kos-pal/philon_imm_robot/PCBs/README.md

These folders contain .json files that can be dragged and dropped in EasyEda to import the schematics as well as the pcb designs for all the boards used in the robot.
