kos-pal/philon_imm_robot/PCBs/servo board/README.md

servo_board

This board connects to the Arduino nano that operates the 3 servo motors. The board implements RS-485 for the UART communication between the modules with a SN75176B ic,
3 optocoupler inputs for reading the inductive sensors used for zeroing the robot as well as terminals for the servo connections.
