kos-pal/philon_imm_robot/PCBs/y-z link board/README.md

y_z_link_board

This board is mounted on top of the X axis and is used to facilitate cabling by splitting the power and signal lines in a convenient location for service and maintenance.
