kos-pal/philon_imm_robot/PCBs/zmod board/README.md

zmod_board

This board connects to the Arduino nano that handles the gripper at the end of the Z axis. The board implements RS-485 for the UART communication between the
modules with a SN75176B ic, 3 relay channels for outputing signals to the Gripper, 3 optocoupler inputs for feedback and a mosfet for controlling the brake of the Z axis servo.
