kos-pal/philon_imm_robot/(threads)

Thread 1 (2023-01-12):

First attempt to run python seems to always fail.

ertygon, 2023-01-12:
Every morning after raspberry boots the first attempt to run communica.py always fail. The second (stop execution of python and run again without rebooting raspbian) always succeeds.
