kos-pal/philon_imm_robot/PCBs/zmod board/SCHEMATIC_z_mod_board.pdf

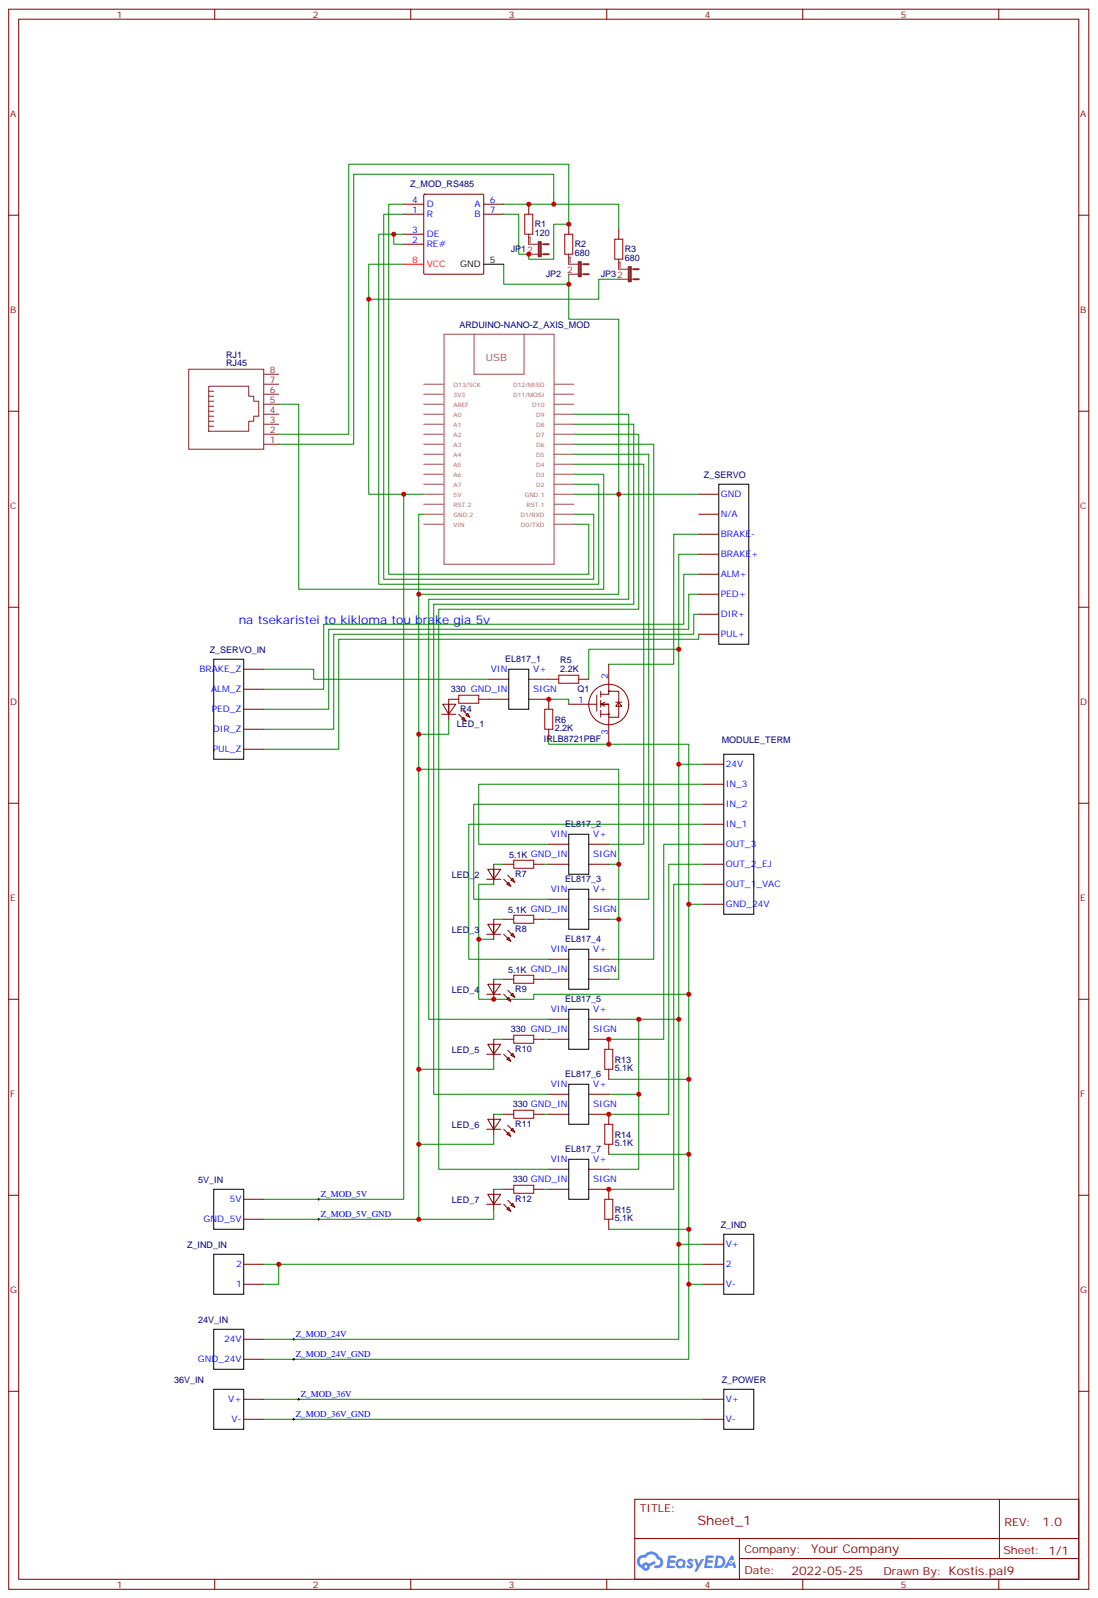
[picture p15: page 1]

na tsekaristei to kikloma tou brake gia 5v
