kos-pal/philon_imm_robot/PCBs/imm board/SCHEMATIC_imm_board.pdf

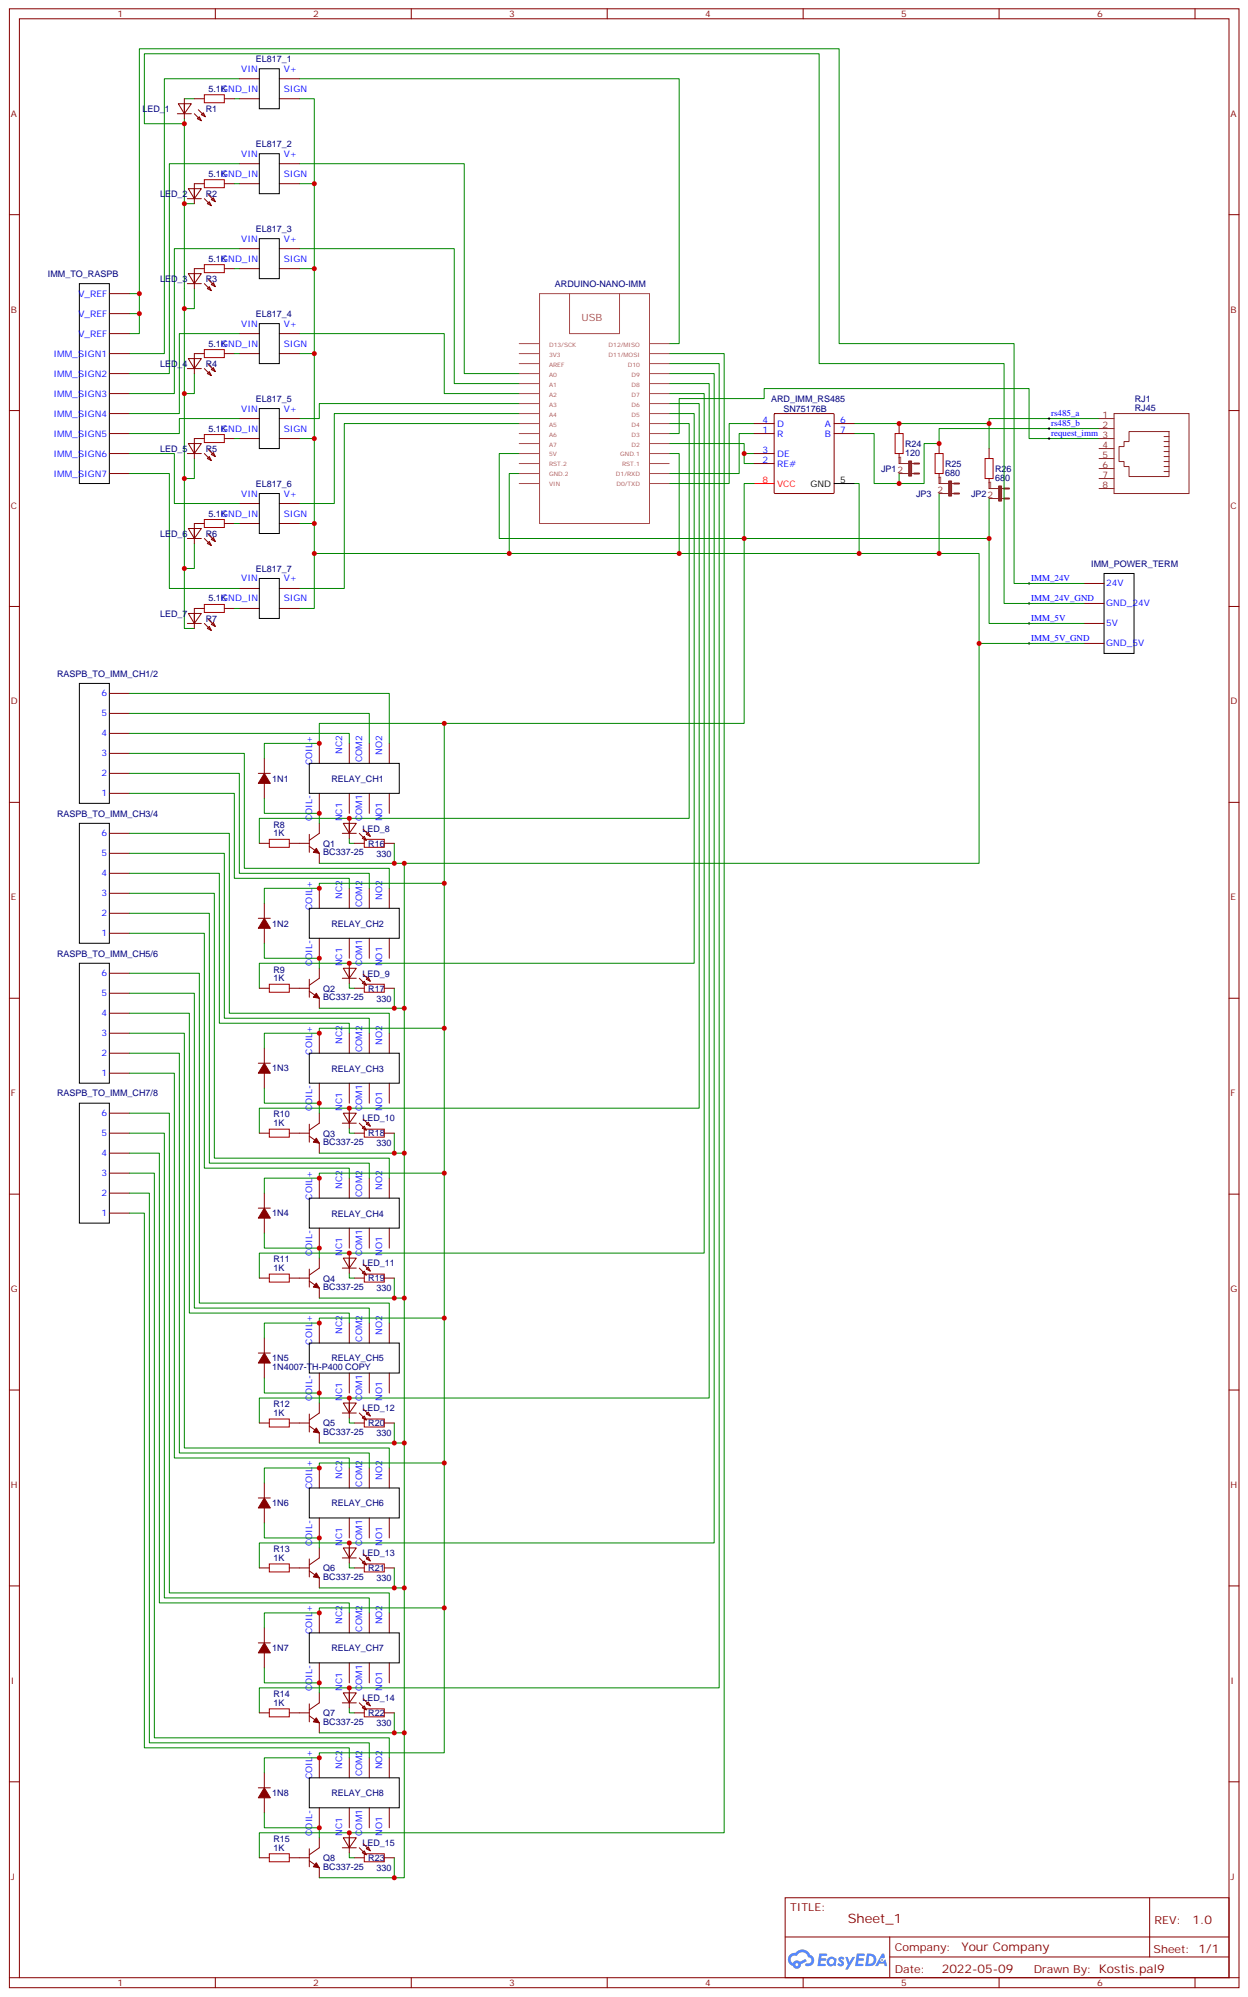
[picture p16: page 1]
