kos-pal/philon_imm_robot/PCBs/raspberry board/SCHEMATIC_raspb_board.pdf

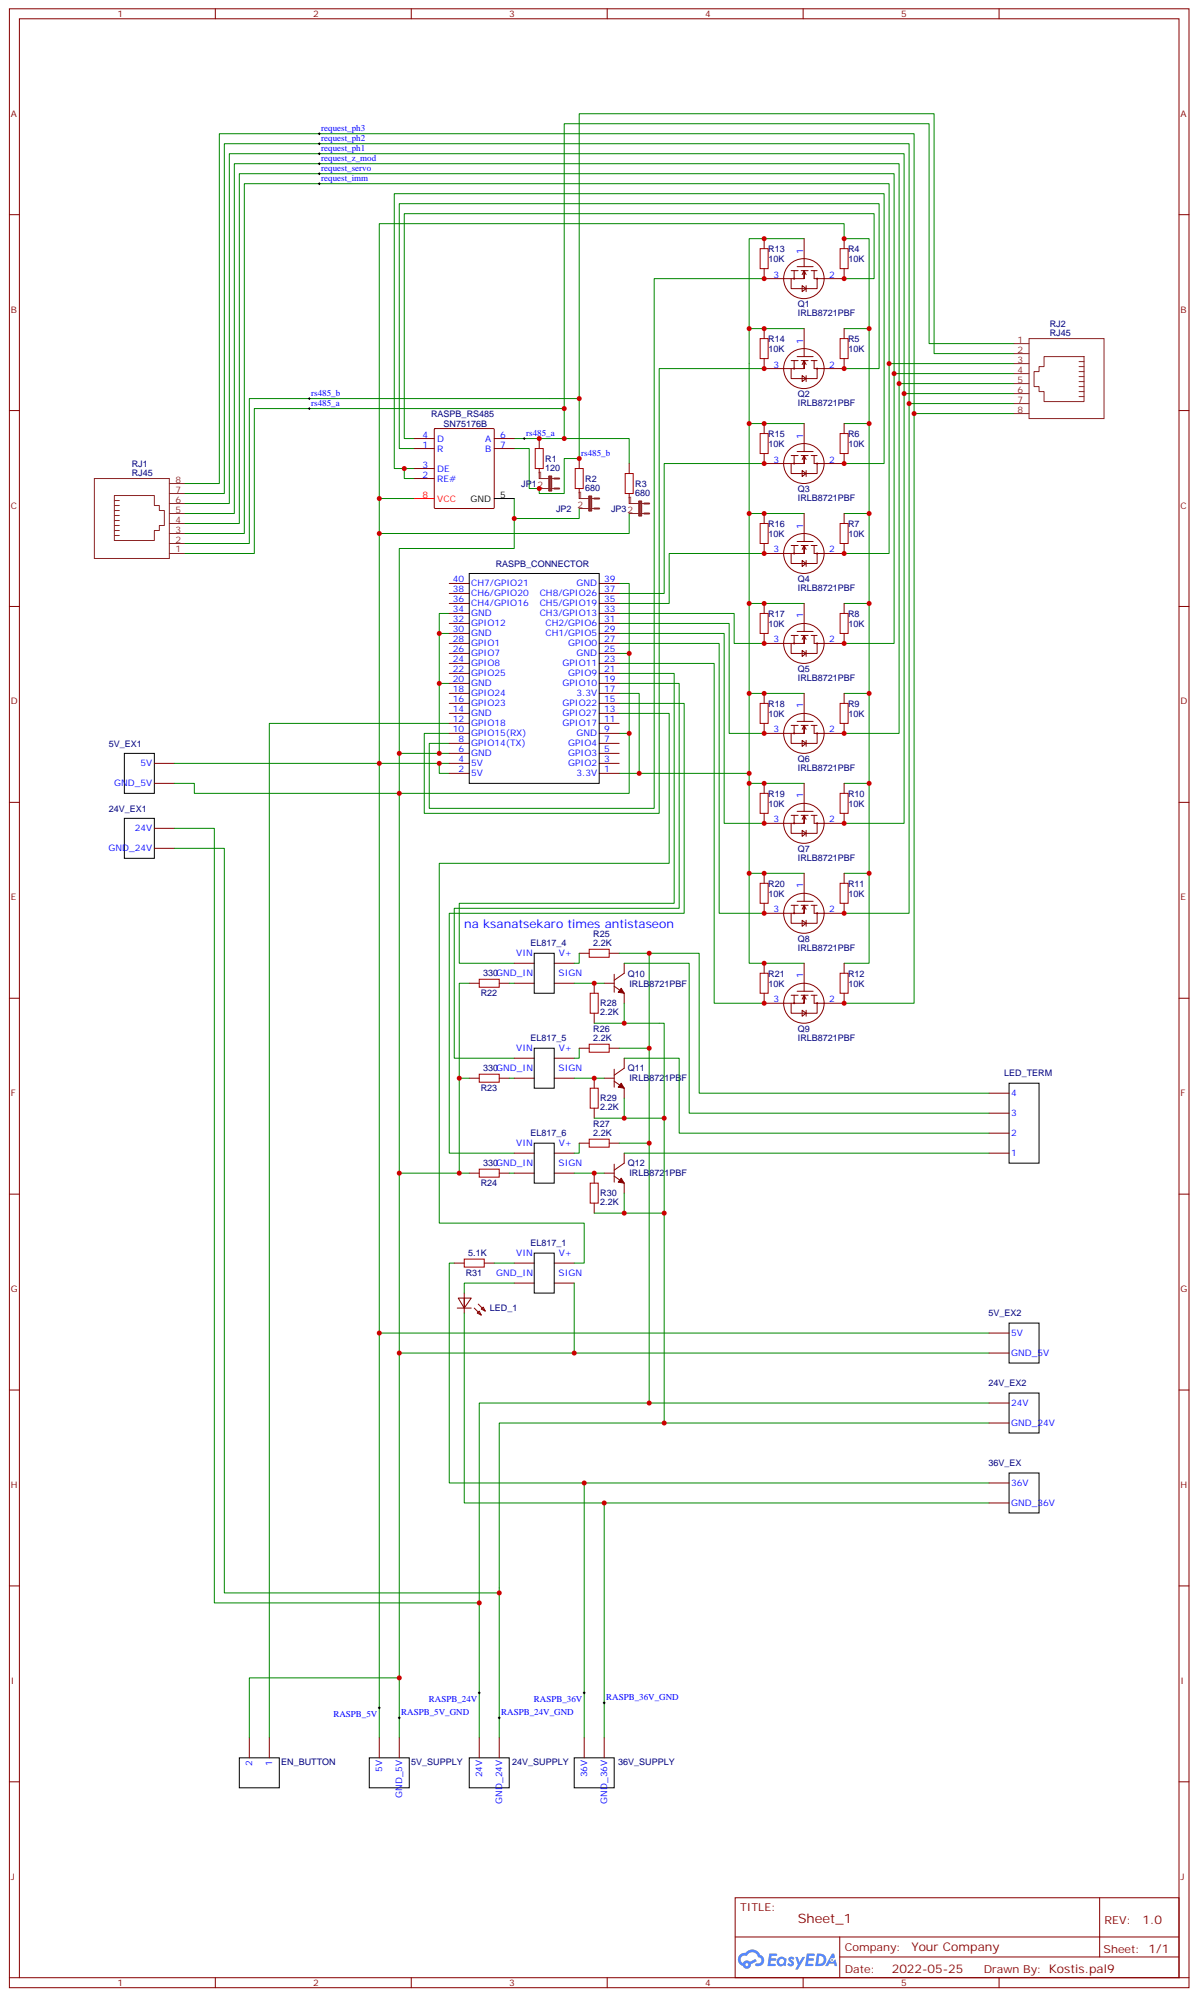
[picture p17: page 1]

request_ph2
request_ph1
request_z_mod
request_servo
request_imm

na ksanatsekaro times antistaseon
