kos-pal/philon_imm_robot/PCBs/servo board/SCHEMATIC_servo_board.pdf

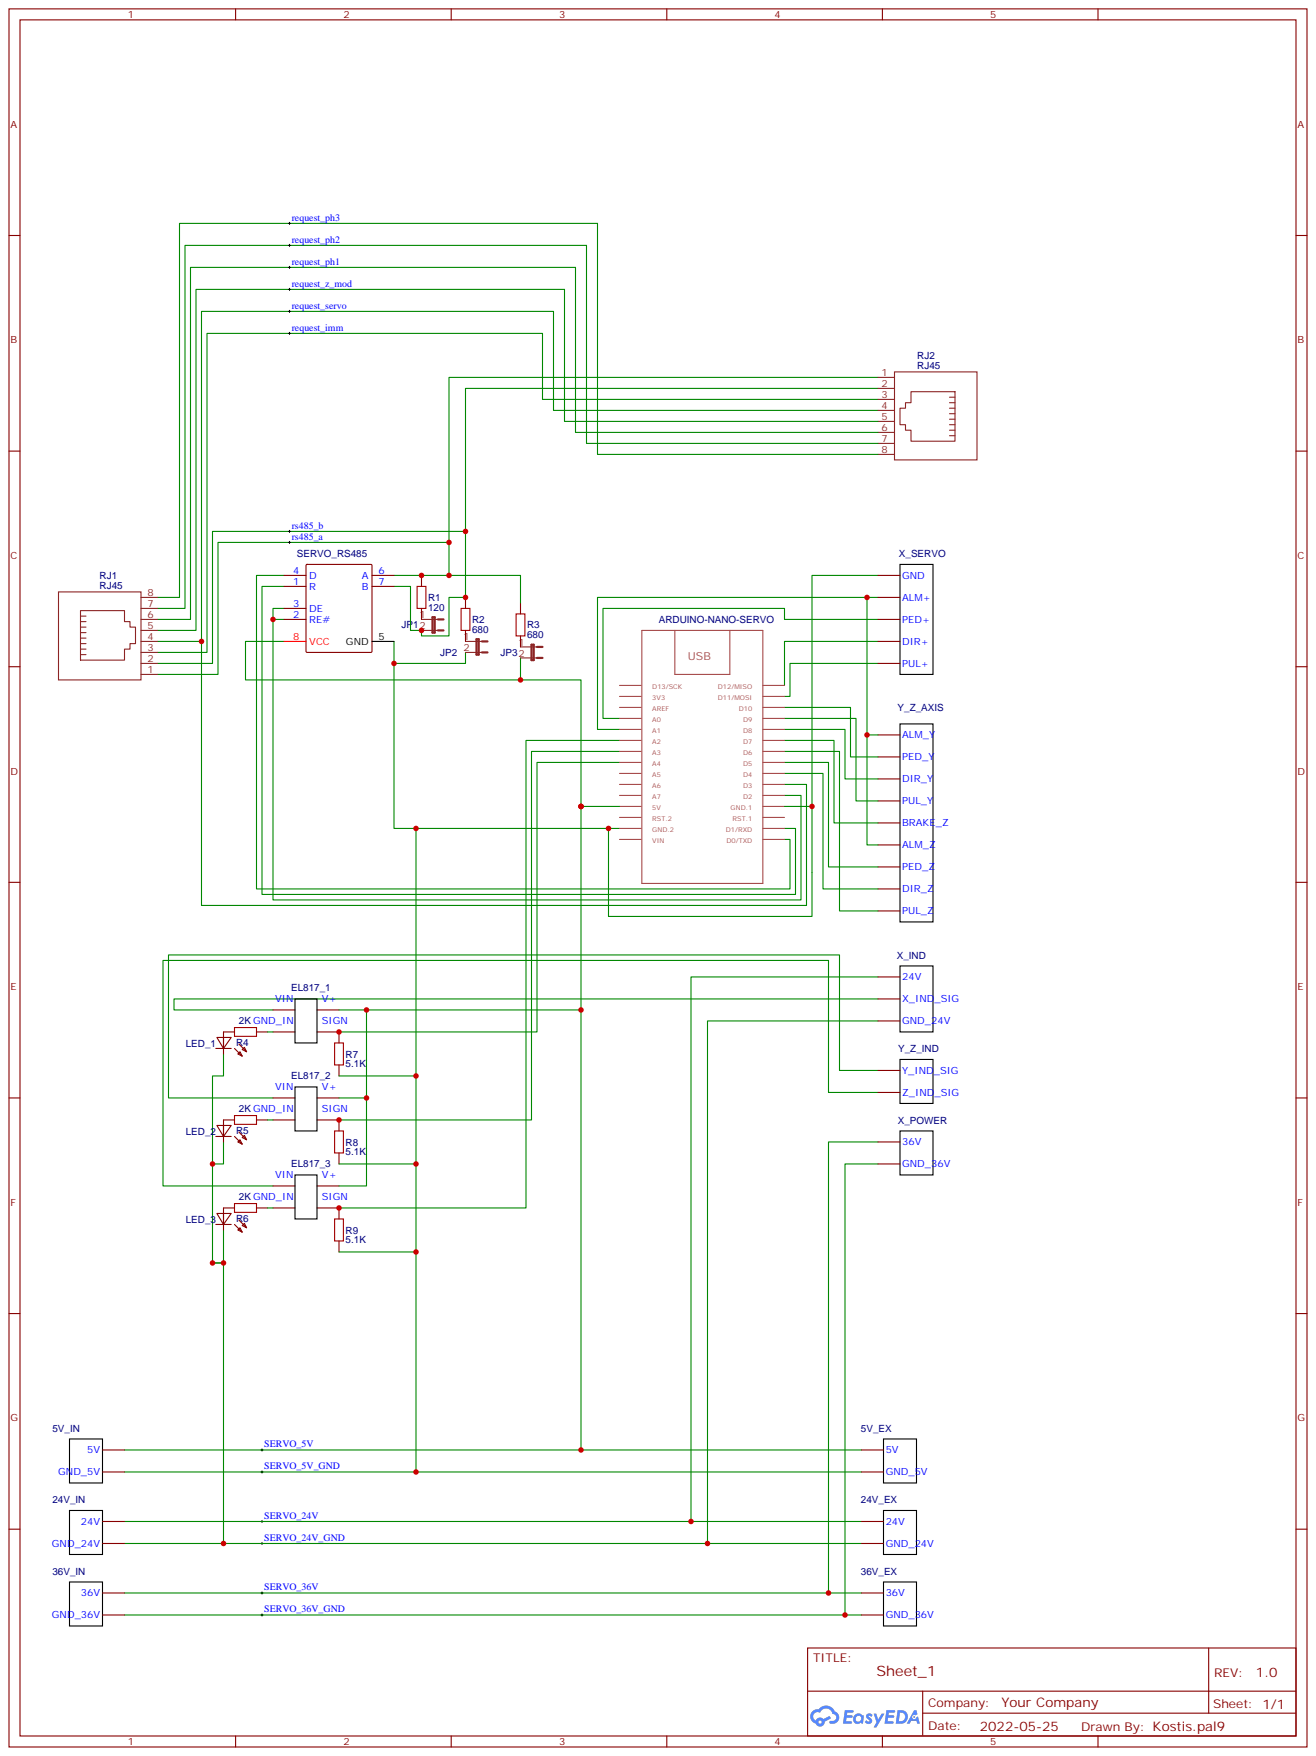
[picture p18: page 1]
