kos-pal/philon_imm_robot/PCBs/y-z link board/SCHEMATIC_y_z_board.pdf

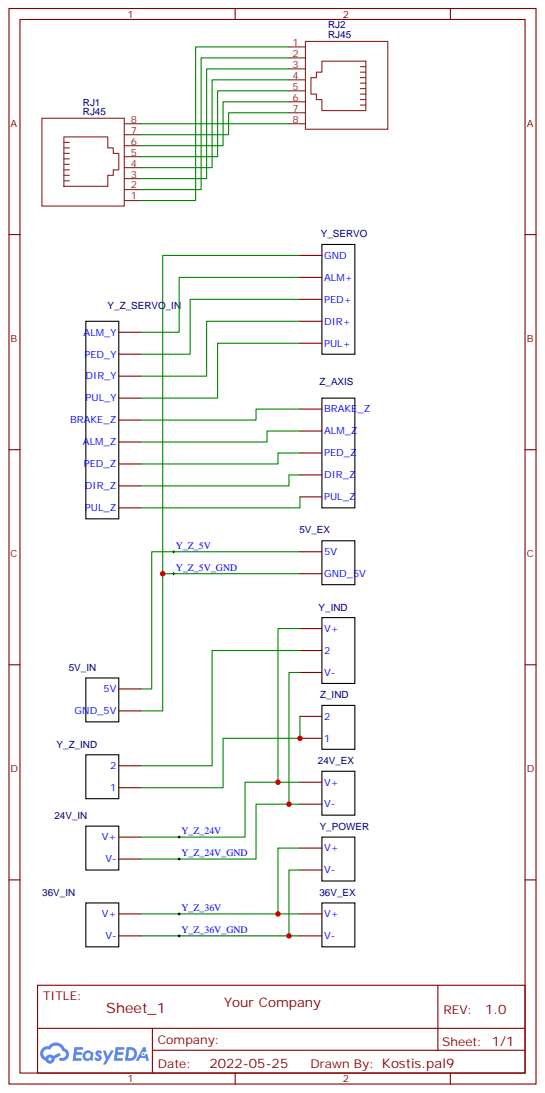
[picture p19: page 1]
