kos-pal/philon_imm_robot/PCBs/imm board/PCB_imm_board.pdf

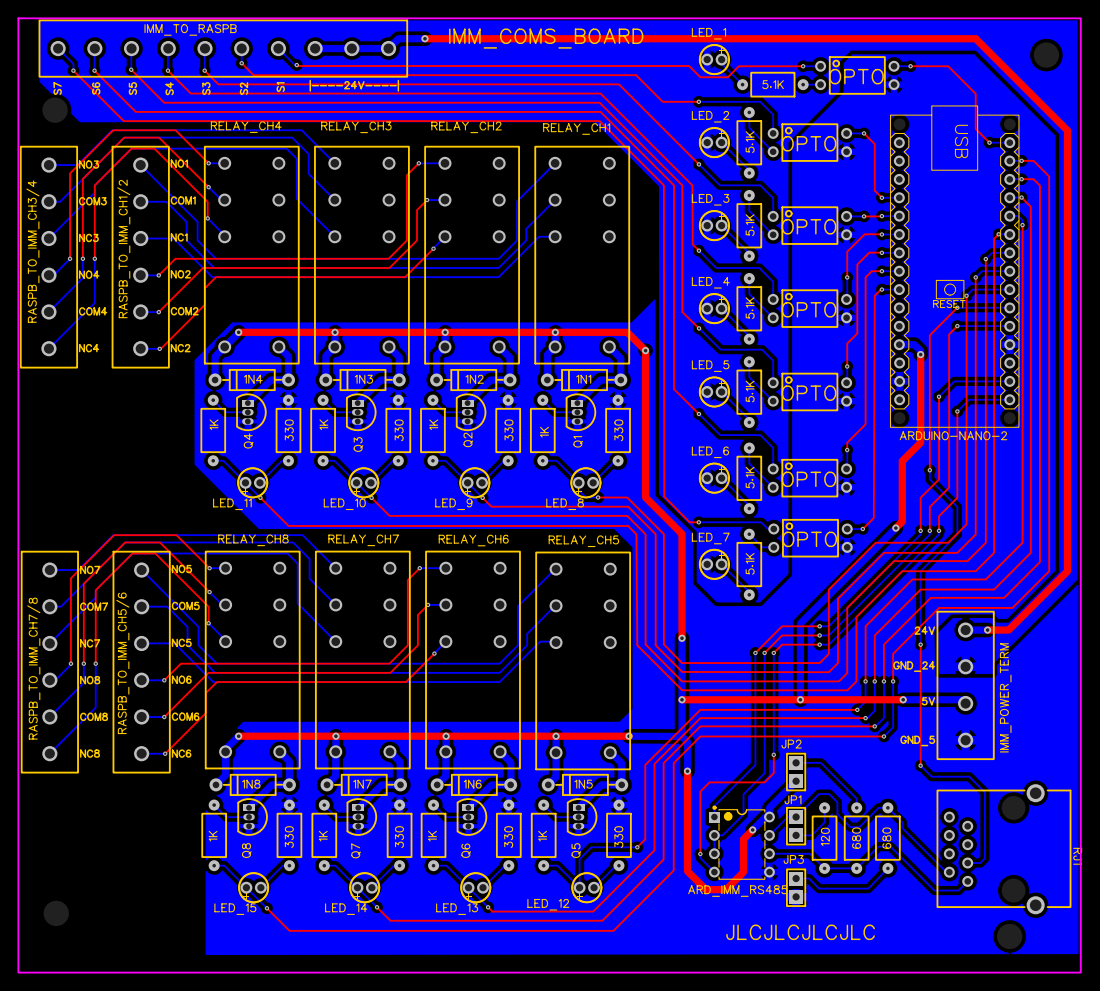
[picture p20: page 1]
