kos-pal/philon_imm_robot/PCBs/raspberry board/PCB_raspb_board.pdf

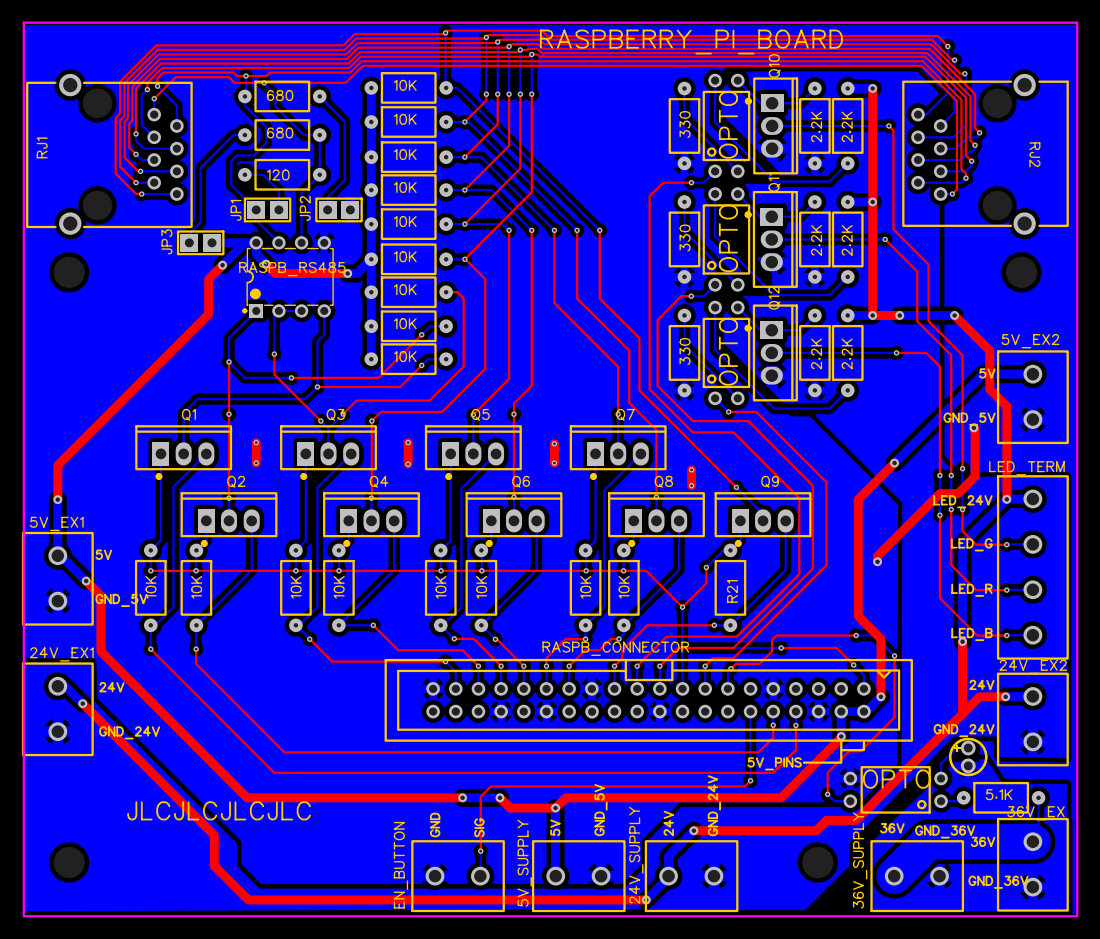
[picture p21: page 1]
