kos-pal/philon_imm_robot/PCBs/servo board/PCB_servo_board.pdf

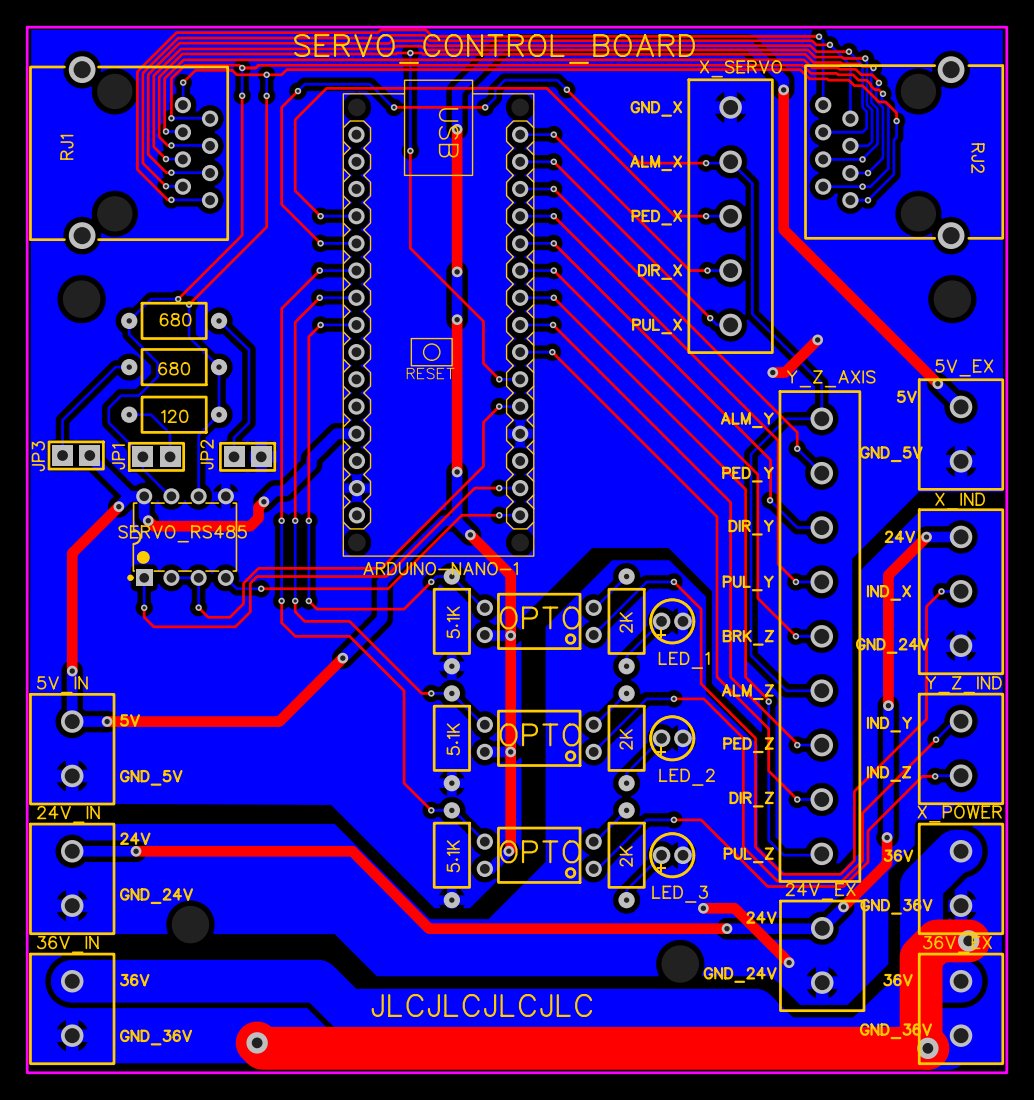
[picture p22: page 1]
