kos-pal/philon_imm_robot/PCBs/y-z link board/PCB_y_z_board.pdf

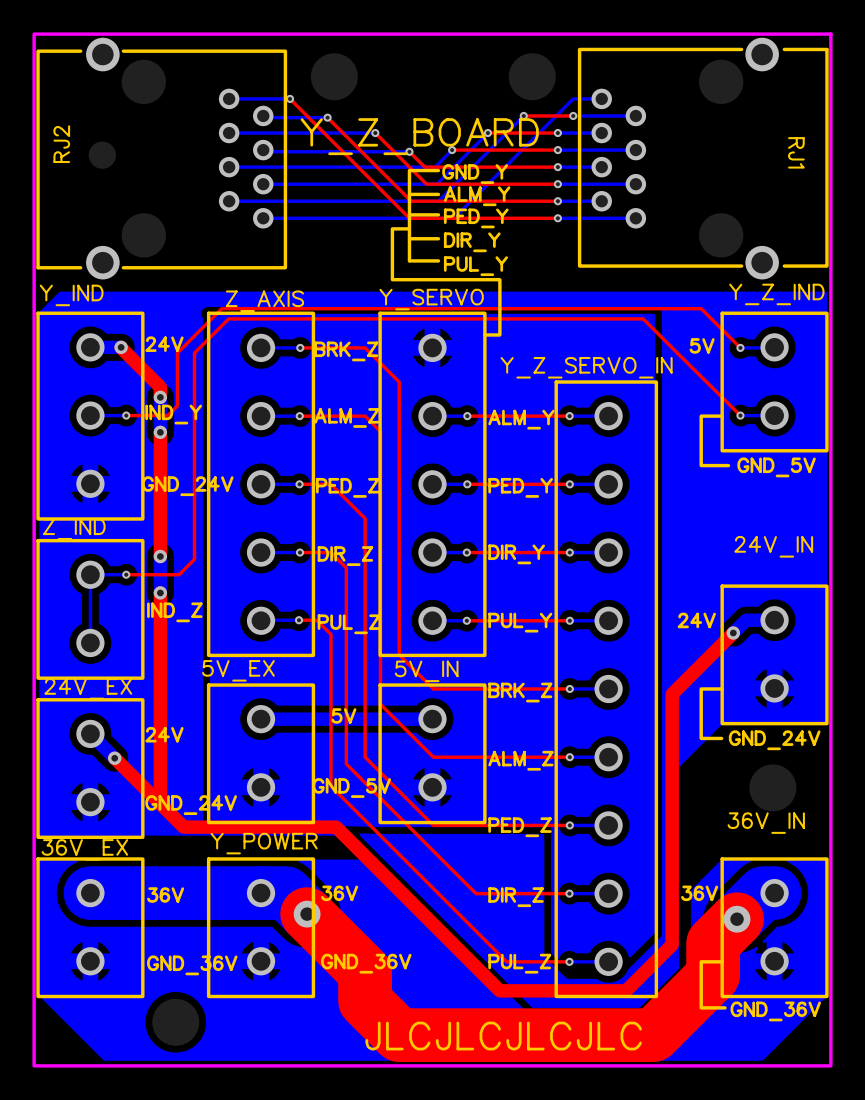
[picture p23: page 1]
