kos-pal/philon_imm_robot/PCBs/zmod board/PCB_z_mod_board.pdf

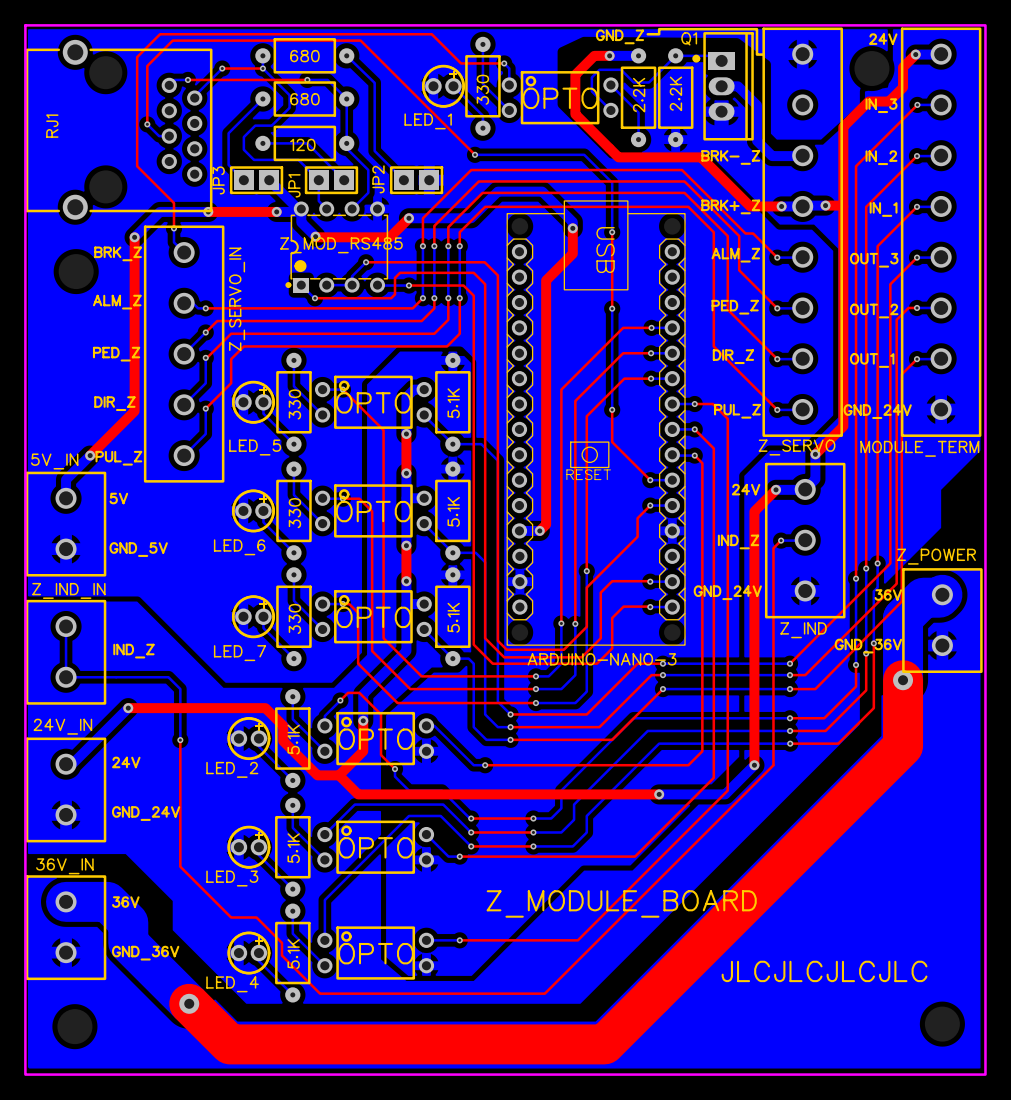
[picture p24: page 1]
