kos-pal/philon_imm_robot/(list of files, drawings)

Other design files:
PCBs/imm board/PCB_imm_board.json
PCBs/imm board/SCH_imm_board.json
PCBs/raspberry board/PCB_raspb_board.json
PCBs/raspberry board/SCH_raspb_board.json
PCBs/servo board/PCB_servo_board.json
PCBs/servo board/SCH_servo_board.json
PCBs/y-z link board/PCB_y_z_board.json
PCBs/y-z link board/SCH_y_z_board.json
PCBs/zmod board/PCB_z_mod_board.json
PCBs/zmod board/SCH_z_mod_board.json
